ParasGore/Rocket-Team---NDTU/NDTU/Tele board.kicad_pcb

## KiCad design NDTU/Tele board.kicad_pcb (2026-11-08)

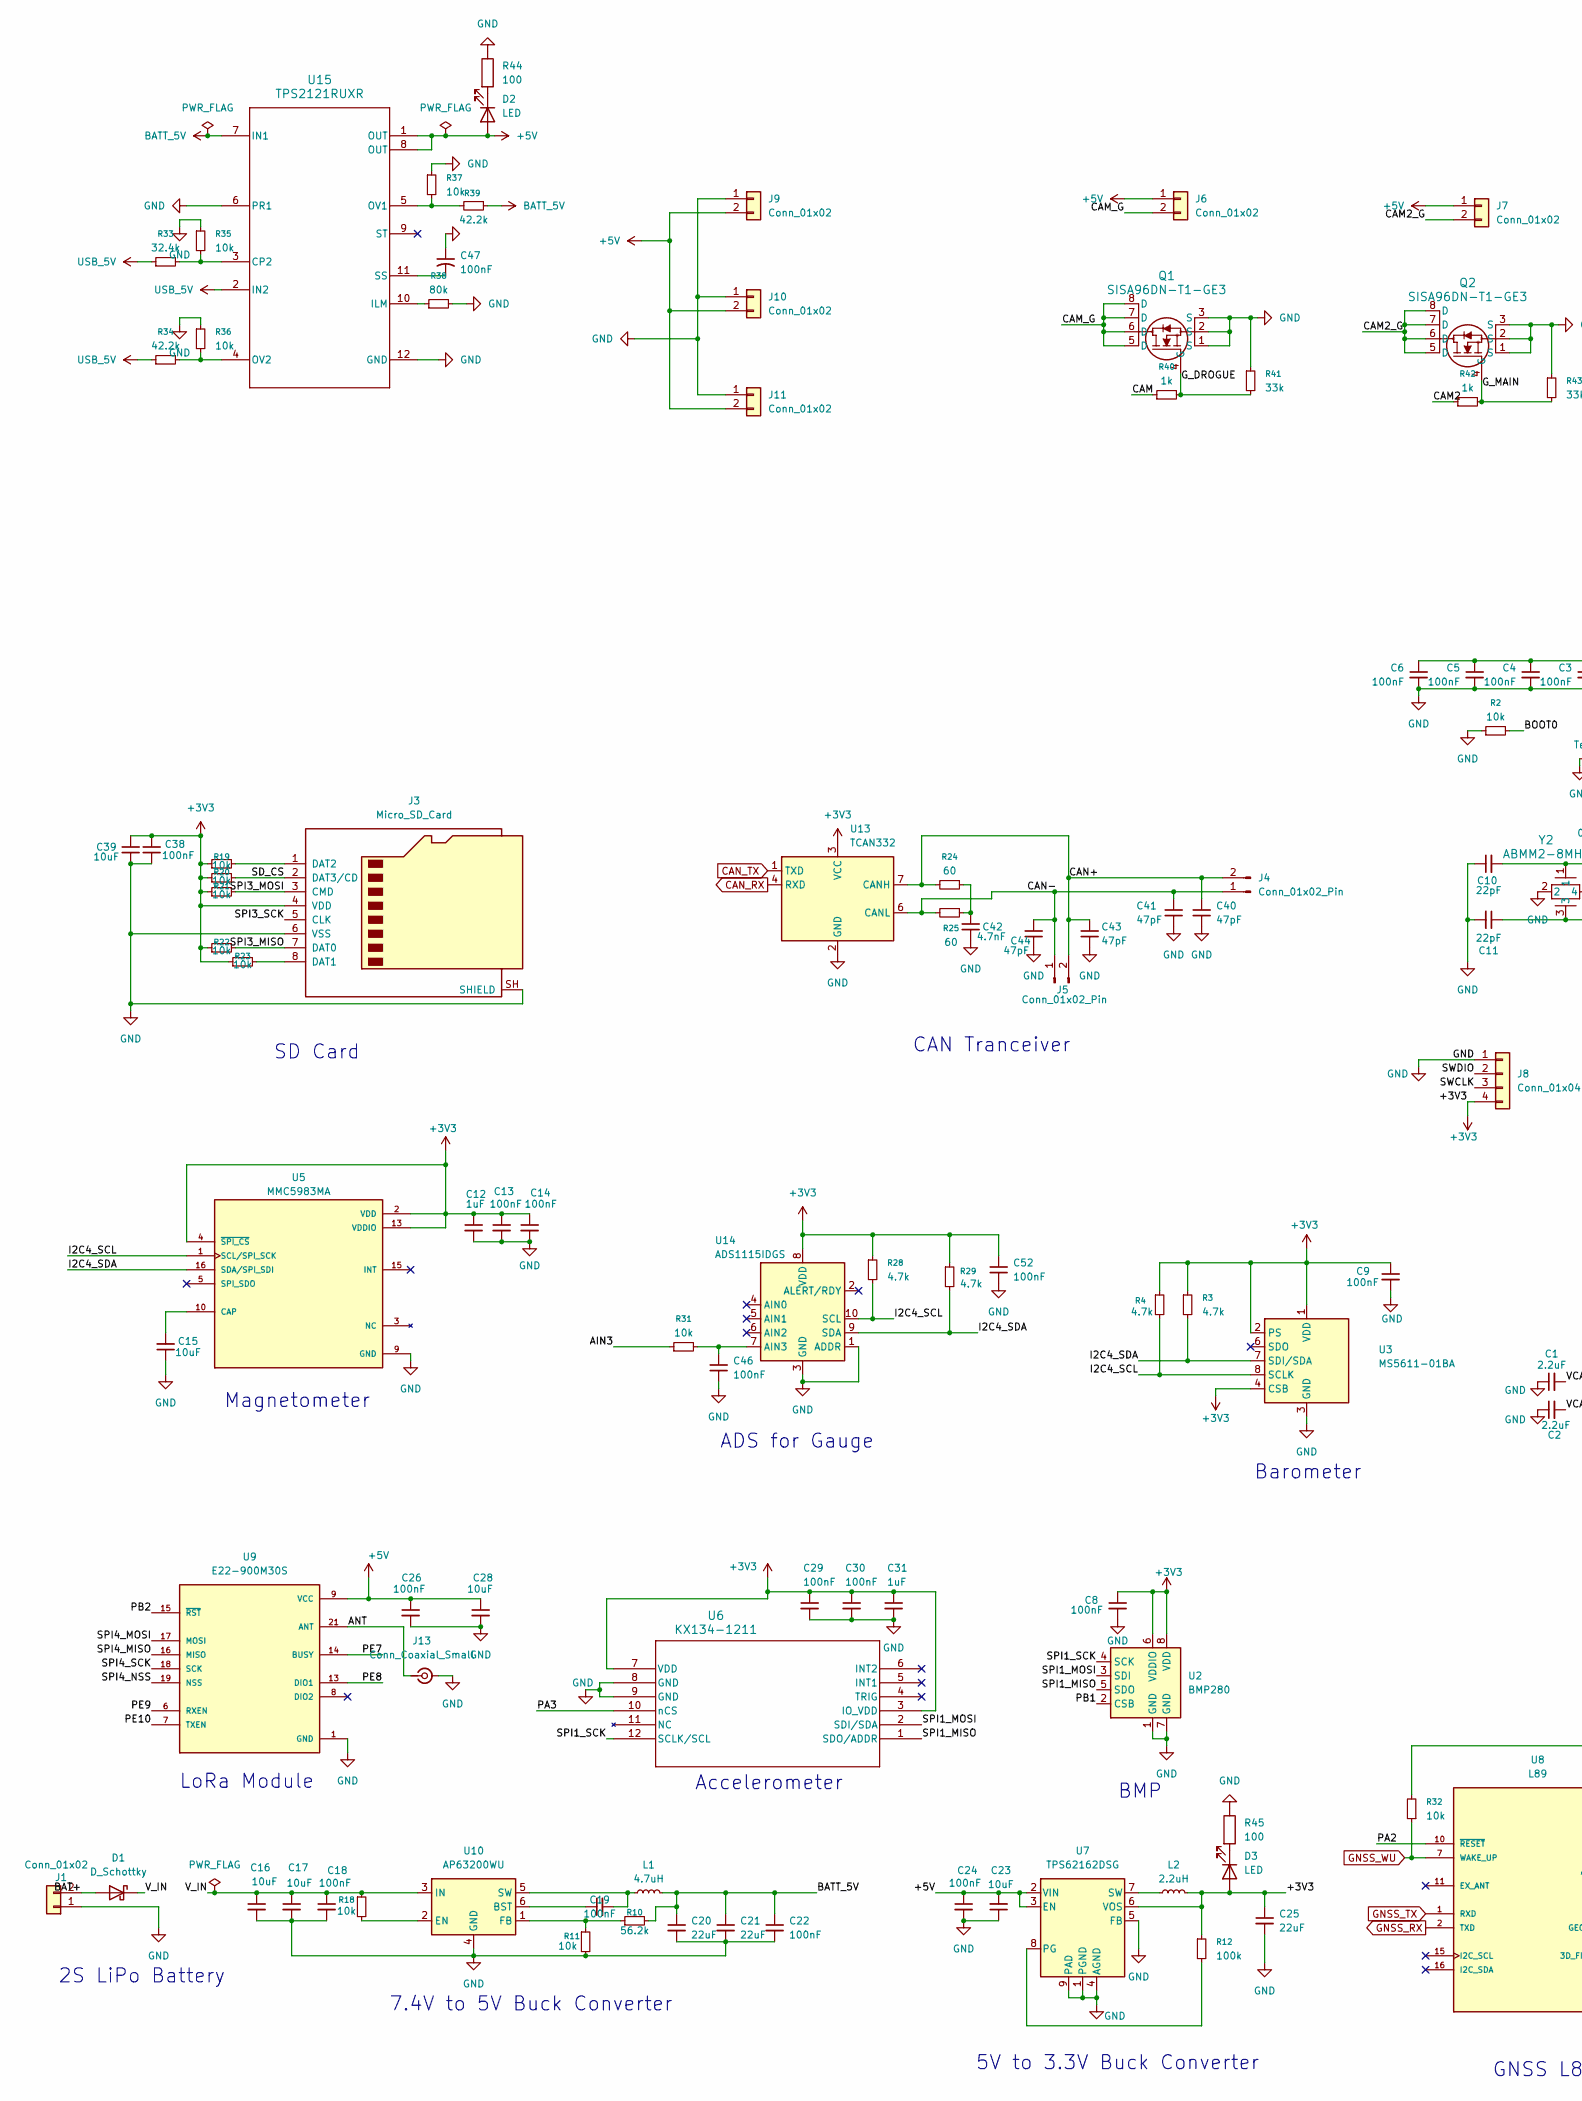
[picture p1: schematic Tele board.kicad_sch, part in row 1, column 1]

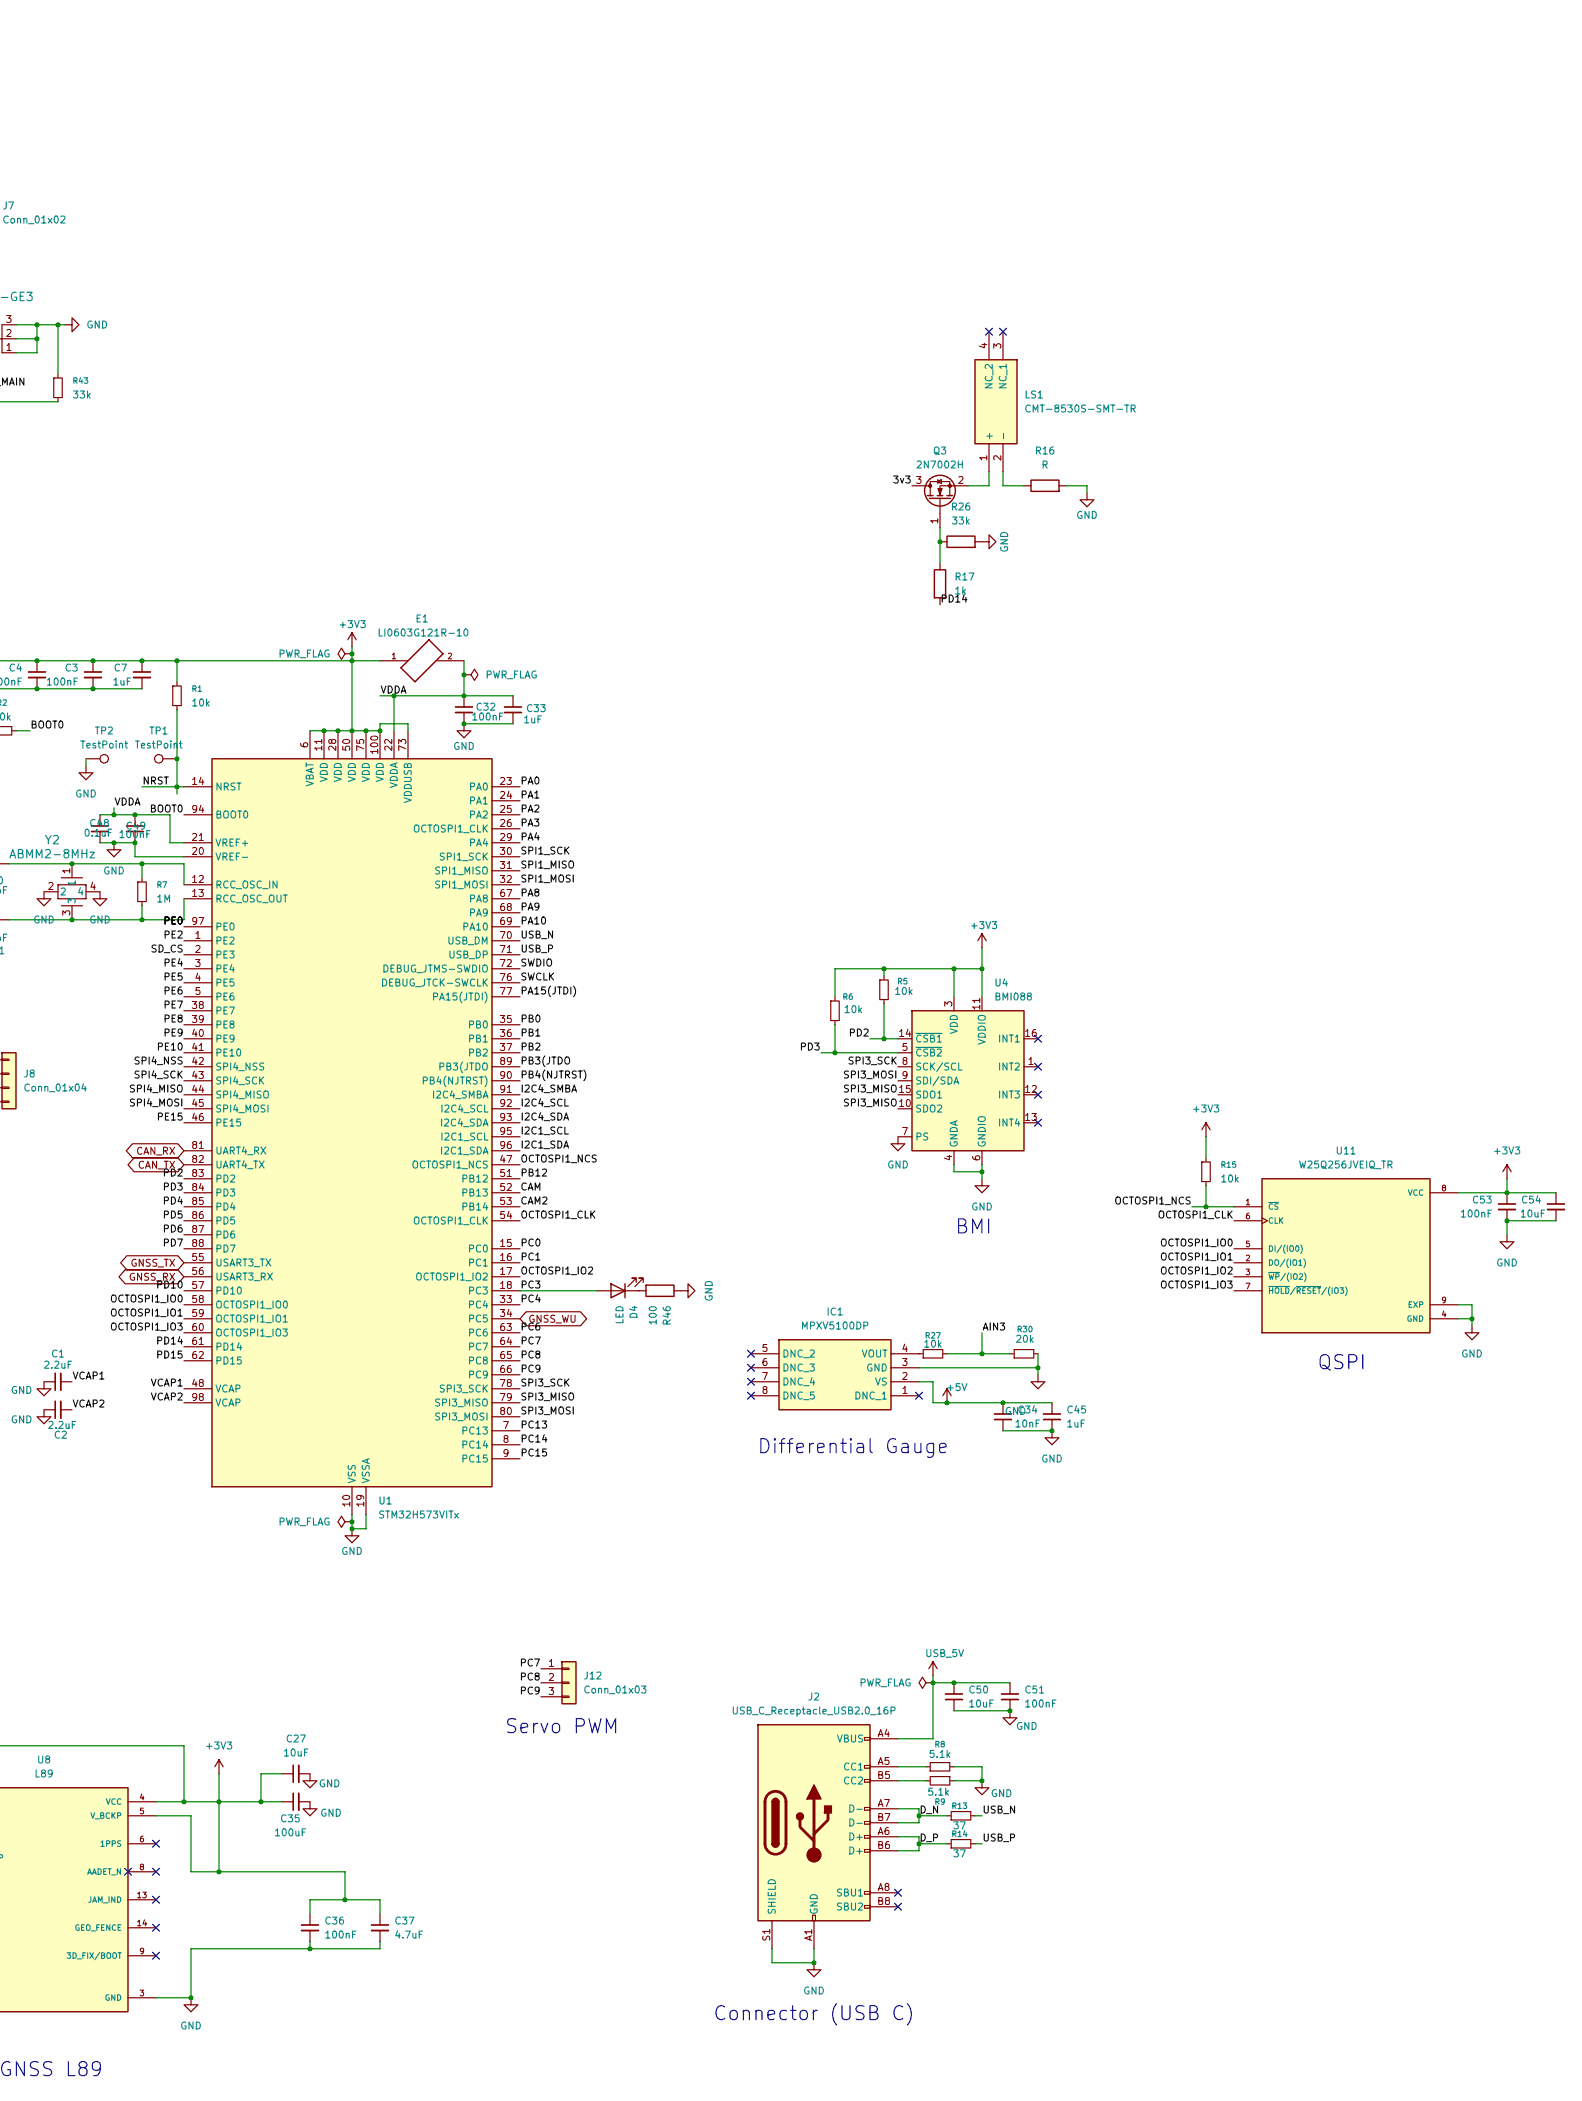
[picture p2: schematic Tele board.kicad_sch, part in row 1, column 2]

Parts:
C1, C2: 2.2uF; C_0603_1608Metric
C3, C4, C5, C6, C8, C9, C13, C14, C18, C19, C22, C24, C26, C29, C30, C32, C36, C38, C46, C47, C49, C51, C52, C53: 100nF; C_0603_1608Metric
C7, C12, C31, C33, C45: 1uF; C_0603_1608Metric
C10, C11: 22pF; C_0603_1608Metric
C15, C16, C17, C23, C27, C28, C39, C50, C54: 10uF; C_0603_1608Metric
C20, C21, C25: 22uF; C_0603_1608Metric
C34: 10nF; C_0603_1608Metric
C35: 100uF; C_0603_1608Metric
C37: 4.7uF; C_0603_1608Metric
C40, C41, C43, C44: 47pF; C_0603_1608Metric
C42: 4.7nF; C_0603_1608Metric
C48: 0.1uF; C_0603_1608Metric
D1: D_Schottky; D_SOD-128
D2, D3, D4: LED; LED_0603_1608Metric
E1: LI0603G121R-10; IND_LI0603G121R-10_LRD-M; PARTREV C
IC1: MPXV5100DP; Manufacturer_Part_Number MPXV5100DP
J1: Conn_01x02; AMASS_XT30U-M_1x02_P5.0mm_Vertical
J2: USB_C_Receptacle_USB2.0_16P; USB_C_Receptacle_GCT_USB4105-xx-A_16P_TopMnt_Horizontal
J3: Micro_SD_Card; microSD_HC_Hirose_DM3AT-SF-PEJM5
J4, J5: Conn_01x02_Pin; JST_EH_B2B-EH-A_1x02_P2.50mm_Vertical
J6, J7, J9, J10, J11: Conn_01x02; JST_EH_B2B-EH-A_1x02_P2.50mm_Vertical
J8: Conn_01x04; JST_EH_B4B-EH-A_1x04_P2.50mm_Vertical
J12: Conn_01x03; AMASS_MR30PW-M_1x03_P3.50mm_Horizontal
J13: Conn_Coaxial_Small; SMA_Samtec_SMA-J-P-H-ST-EM1_EdgeMount
L1: 4.7uH; L_Coilcraft_XAL4020-XXX
L2: 2.2uH; L_Coilcraft_XAL4020-XXX
LS1: CMT-8530S-SMT-TR; CMT8530SSMTTR; Manufacturer_Part_Number CMT-8530S-SMT-TR; Mouser Part Number 490-CMT-8530S-SMT-TR
Q1, Q2: SISA96DN-T1-GE3; SIS862DNT1GE3
Q3: 2N7002H; SOT-23
R1, R2, R5, R6, R11, R15, R18, R19, R20, R21, R22, R23, R27, R31, R32, R35, R36, R37: 10k; R_0603_1608Metric
R3, R4, R28, R29: 4.7k; R_0603_1608Metric
R7: 1M; R_0603_1608Metric
R8, R9: 5.1k; R_0603_1608Metric
R10: 56.2k; R_0603_1608Metric
R12: 100k; R_0603_1608Metric
R13, R14: 37; R_0603_1608Metric
R16: R; R_0603_1608Metric
R17, R40, R42: 1k; R_0603_1608Metric
R24, R25: 60; R_0603_1608Metric
R26, R41, R43: 33k; R_0603_1608Metric
R30: 20k; R_0603_1608Metric
R33: 32.4k; R_0603_1608Metric
R34, R39: 42.2k; R_0603_1608Metric
R38: 80k; R_0603_1608Metric
R44, R45, R46: 100; R_0603_1608Metric
TP1, TP2: TestPoint; TestPoint_Pad_2.0x2.0mm
U1: STM32H573VITx; LQFP-100_14x14mm_P0.5mm
U2: BMP280; Bosch_LGA-8_2x2.5mm_P0.65mm_ClockwisePinNumbering
U3: MS5611-01BA; LGA-8_3x5mm_P1.25mm
U4: BMI088; Bosch_LGA-16_4.5x3mm_P0.5mm_LayoutBorder7x1y_ClockwisePinNu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
U5: MMC5983MA; PQFN50P300X300X100-16N; PARTREV A
U6: KX134-1211; LGA12_2X2X0P9_ROM-M
U7: TPS62162DSG; Texas_DSG0008A_WSON-8-1EP_2x2mm_P0.5mm_EP0.9x1.6mm_ThermalV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
U8: L89; XCVR_L89; PARTREV 1.1
U9: E22-900M30S; XCVR_E22-900M30S; PARTREV 1.2
U10: AP63200WU; TSOT-23-6
U11: W25Q256JVEIQ_TR; W25Q256JVEIQ; MPN W25Q256JVEIQ TR
U13: TCAN332; SOIC-8_3.9x4.9mm_P1.27mm
U14: ADS1115IDGS; TSSOP-10_3x3mm_P0.5mm
U15: TPS2121RUXR; IC_TPS2121RUXR
Y2: ABMM2-8MHz; CRYSTAL_ABMM2_ABR

Connections:
+3V3: C3.1, C4.1, C5.1, C6.1, C7.1, C8.1, C9.1, C12.1, C13.1, C14.1, C25.1, C27.1, C29.1, C30.1, C31.1, C35.1, C36.1, C37.1, C38.1, C39.1, C52.1, C53.1, C54.1, D3.2 (A), E1.1, J3.4 (VDD), J8.4, L2.2, R1.1, R3.1, R4.1, R5.1, R6.1, R12.1, R15.1, R19.1, R20.1, R21.1, R22.1, R23.1, R28.1, R29.1, R32.2, U1.6 (VBAT), U1.11 (VDD), U1.28 (VDD), U1.50 (VDD), U1.73 (VDDUSB), U1.75 (VDD), U1.100 (VDD), U2.6 (VDDIO), U2.8 (VDD), U3.1 (VDD), U3.2 (PS), U3.4 (CSB), U3.5 (CSB), U4.3 (VDD), U4.11 (VDDIO), U5.2 (VDD), U5.4 (~SPI_CS), U5.13 (VDDIO), U6.3 (IO_VDD), U6.7 (VDD), U7.6 (VOS), U8.4 (VCC), U8.5 (V_BCKP), U11.8 (VCC), U13.3 (VCC), U14.8 (VDD)
+5V: C23.2, C24.1, C26.1, C28.1, C34.1, C45.1, D2.2 (A), IC1.2 (VS), J6.1, J7.1, J9.2, J10.2, J11.2, U7.2 (VIN), U7.3 (EN), U9.9 (VCC), U9.10 (VCC), U15.1 (OUT), U15.8 (OUT)
/3v3: Q3.3 (D)
/AIN3: R27.2, R30.1, R31.1
/ANT: J13.1 (In), U9.21 (ANT)
/BAT+: D1.2 (A), J1.2
/BOOT0: R2.2, U1.94 (BOOT0)
/CAM: R40.1, U1.52 (PB13)
/CAM2: R42.1, U1.53 (PB14)
/CAM2_G: J7.2, Q2.5 (D), Q2.6 (D), Q2.7 (D), Q2.8 (D)
/CAM_G: J6.2, Q1.5 (D), Q1.6 (D), Q1.7 (D), Q1.8 (D)
/CAN+: C40.1, C43.1, J4.2, J5.2, R24.2, U13.7 (CANH); also elsewhere on the board
/CAN-: C41.1, C44.1, J4.1, J5.1, R25.2, U13.6 (CANL); also elsewhere on the board
/D_N: J2.A7 (D-), J2.B7 (D-), R13.1
/D_P: J2.A6 (D+), J2.B6 (D+), R14.1
/G_DROGUE: Q1.4 (G), R40.2, R41.2
/G_MAIN: Q2.4 (G), R42.2, R43.2
/I2C1_SCL: U1.95 (I2C1_SCL)
/I2C1_SDA: U1.96 (I2C1_SDA)
/I2C4_SCL: R4.2, R28.2, U1.92 (I2C4_SCL), U3.8 (SCLK), U5.1 (SCL/SPI_SCK), U14.10 (SCL)
/I2C4_SDA: R3.2, R29.2, U1.93 (I2C4_SDA), U3.7 (SDI/SDA), U5.16 (SDA/SPI_SDI), U14.9 (SDA)
/I2C4_SMBA: U1.91 (I2C4_SMBA)
/NRST: R1.2, TP1.1 (1_1), U1.14 (NRST)
/OCTOSPI1_CLK: U1.54 (OCTOSPI1_CLK), U11.6 (CLK)
/OCTOSPI1_IO0: U1.58 (OCTOSPI1_IO0), U11.5 (DI/(IO0))
/OCTOSPI1_IO1: U1.59 (OCTOSPI1_IO1), U11.2 (DO/(IO1))
/OCTOSPI1_IO2: U1.17 (OCTOSPI1_IO2), U11.3 (~WP/(IO2))
/OCTOSPI1_IO3: U1.60 (OCTOSPI1_IO3), U11.7 (~HOLD/~RESET/(IO3))
/OCTOSPI1_NCS: R15.2, U1.47 (OCTOSPI1_NCS), U11.1 (~CS)
/PA0: U1.23 (PA0)
/PA1: U1.24 (PA1)
/PA2: U1.25 (PA2), U8.10 (~RESET)
/PA3: U1.26 (OCTOSPI1_CLK), U6.10 (nCS)
/PA4: U1.29 (PA4)
/PA8: U1.67 (PA8)
/PA9: U1.68 (PA9)
/PA10: U1.69 (PA10)
/PA15(JTDI): U1.77 (PA15(JTDI))
/PB0: U1.35 (PB0)
/PB1: U1.36 (PB1), U2.2 (CSB)
/PB2: U1.37 (PB2), U9.15 (~RST)
/PB3(JTDO: U1.89 (PB3(JTDO)
/PB4(NJTRST): U1.90 (PB4(NJTRST))
/PB12: U1.51 (PB12)
/PC0: U1.15 (PC0)
/PC1: U1.16 (PC1)
/PC3: D4.2 (A), U1.18 (PC3)
/PC4: U1.33 (PC4)
/PC6: U1.63 (PC6)
/PC7: J12.1, U1.64 (PC7)
/PC8: J12.2, U1.65 (PC8)
/PC9: J12.3, U1.66 (PC9)
/PC13: U1.7 (PC13)
/PC14: U1.8 (PC14)
/PC15: U1.9 (PC15)
/PD2: R5.2, U1.83 (PD2), U4.14 (~CSB1)
/PD3: R6.2, U1.84 (PD3), U4.5 (~CSB2)
/PD4: U1.85 (PD4)
/PD5: U1.86 (PD5)
/PD6: U1.87 (PD6)
/PD7: U1.88 (PD7)
/PD10: U1.57 (PD10)
/PD14: R17.2, U1.61 (PD14)
/PD15: U1.62 (PD15)
/PE0: U1.97 (PE0)
/PE2: U1.1 (PE2)
/PE4: U1.3 (PE4)
/PE5: U1.4 (PE5)
/PE6: U1.5 (PE6)
/PE7: U1.38 (PE7), U9.14 (BUSY)
/PE8: U1.39 (PE8), U9.13 (DIO1)
/PE9: U1.40 (PE9), U9.6 (RXEN)
/PE10: U1.41 (PE10), U9.7 (TXEN)
/PE15: U1.46 (PE15)
/SD_CS: J3.2 (DAT3/CD), R20.2, U1.2 (PE3)
/SPI1_MISO: U1.31 (SPI1_MISO), U2.5 (SDO), U6.1 (SDO/ADDR)
/SPI1_MOSI: U1.32 (SPI1_MOSI), U2.3 (SDI), U6.2 (SDI/SDA)
/SPI1_SCK: U1.30 (SPI1_SCK), U2.4 (SCK), U6.12 (SCLK/SCL)
/SPI3_MISO: J3.7 (DAT0), R22.2, U1.79 (SPI3_MISO), U4.10 (SDO2), U4.15 (SDO1)
/SPI3_MOSI: J3.3 (CMD), R21.2, U1.80 (SPI3_MOSI), U4.9 (SDI/SDA)
/SPI3_SCK: J3.5 (CLK), U1.78 (SPI3_SCK), U4.8 (SCK/SCL)
/SPI4_MISO: U1.44 (SPI4_MISO), U9.16 (MISO)
/SPI4_MOSI: U1.45 (SPI4_MOSI), U9.17 (MOSI)
/SPI4_NSS: U1.42 (SPI4_NSS), U9.19 (NSS)
/SPI4_SCK: U1.43 (SPI4_SCK), U9.18 (SCK)
/SWCLK: J8.3, U1.76 (DEBUG_JTCK-SWCLK)
/SWDIO: J8.2, U1.72 (DEBUG_JTMS-SWDIO)
/USB_N: R13.2, U1.70 (USB_DM)
/USB_P: R14.2, U1.71 (USB_DP)
/VCAP1: C1.2, U1.48 (VCAP)
/VCAP2: C2.2, U1.98 (VCAP)
/VDDA: C32.1, C33.1, C48.1, C49.1, E1.2, U1.21 (VREF+), U1.22 (VDDA)
/V_IN: C16.1, C17.1, C18.1, D1.1 (K), R18.1, U10.3 (IN)
BATT_5V: C20.1, C21.1, C22.1, L1.2, R10.2, R39.1, U15.7 (IN1)
CAN_RX: U1.81 (UART4_RX), U13.4 (RXD)
CAN_TX: U1.82 (UART4_TX), U13.1 (TXD)
GND: C1.1, C2.1, C3.2, C4.2, C5.2, C6.2, C7.2, C8.2, C9.2, C10.1, C11.2, C12.2, C13.2, C14.2, C15.1, C16.2, C17.2, C18.2, C20.2, C21.2, C22.2, C23.1, C24.2, C25.2, C26.2, C27.2, C28.2, C29.2, C30.2, C31.2, C32.2, C33.2, C34.2, C35.2, C36.2, C37.2, C38.2, C39.2, C40.2, C41.2, C42.2, C43.2, C44.2, C45.2, C46.2, C47.1, C48.2, C49.2, C50.2, C51.2, C52.2, C53.2, C54.2, IC1.3 (GND), J1.1, J2.A1 (GND), J2.A12 (GND), J2.B1 (GND), J2.B12 (GND), J2.S1 (SHIELD), J3.6 (VSS), J3.SH (SHIELD), J8.1, J9.1, J10.1, J11.1, J13.2 (Ext), Q1.1 (S), Q1.2 (S), Q1.3 (S), Q2.1 (S), Q2.2 (S), Q2.3 (S), R2.1, R8.2, R9.1, R11.2, R16.2, R26.2, R30.2, R35.1, R36.1, R37.1, R38.2, R41.1, R43.1, R44.1, R45.1, R46.1, TP2.1 (1_1), U1.10 (VSS), U1.19 (VSSA), U1.20 (VREF-), U1.27 (VSS), U1.49 (VSS), U1.74 (VSS), U1.99 (VSS), U2.1 (GND), U2.7 (GND), U3.3 (GND), U4.2 (GNDA), U4.4 (GNDA), U4.6 (GNDIO), U4.7 (PS), U5.9 (GND), U5.11 (GND), U6.8 (GND), U6.9 (GND), U7.1 (PGND), U7.4 (AGND), U7.5 (FB), U7.9 (PAD), U8.3 (GND), U8.12 (GND), U9.1 (GND), U9.2 (GND), U9.3 (GND), U9.4 (GND), U9.5 (GND), U9.11 (GND), U9.12 (GND), U9.20 (GND), U9.22 (GND), U10.4 (GND), U11.4 (GND), U11.9 (EXP), U13.2 (GND), U14.1 (ADDR), U14.3 (GND), U15.6 (PR1), U15.12 (GND), Y2.2, Y2.4; also elsewhere on the board
GNSS_RX: U1.56 (USART3_RX), U8.2 (TXD)
GNSS_TX: U1.55 (USART3_TX), U8.1 (RXD)
GNSS_WU: R32.1, U1.34 (PC5), U8.7 (WAKE_UP)
unnamed: C42.1, R24.1, R25.1
unnamed: D2.1 (K), R44.2
unnamed: D3.1 (K), R45.2
unnamed: D4.1 (K), R46.2
unnamed: IC1.4 (VOUT), R27.1
unnamed: J2.A5 (CC1), R8.1
unnamed: J2.B5 (CC2), R9.2
unnamed: J3.8 (DAT1), R23.2
unnamed: J3.1 (DAT2), R19.2
unnamed: LS1.1 (+), Q3.2 (S)
unnamed: LS1.2 (-), R16.1
unnamed: Q3.1 (G), R17.1, R26.1
unnamed: C10.2, R7.1, U1.12 (RCC_OSC_IN), Y2.1
unnamed: C11.1, R7.2, U1.13 (RCC_OSC_OUT), Y2.3
unnamed: C15.2, U5.10 (CAP)
unnamed: R12.2, U7.8 (PG)
unnamed: L2.1, U7.7 (SW)
unnamed: C19.1, U10.6 (BST)
unnamed: R18.2, U10.2 (EN)
unnamed: R10.1, R11.1, U10.1 (FB)
unnamed: C19.2, L1.1, U10.5 (SW)
unnamed: C46.1, R31.2, U14.7 (AIN3)
unnamed: R33.2, R35.2, U15.3 (CP2)
unnamed: R38.1, U15.10 (ILM)
unnamed: R37.2, R39.2, U15.5 (OV1)
unnamed: R34.2, R36.2, U15.4 (OV2)
unnamed: C47.2, U15.11 (SS)
USB_5V: C50.1, C51.1, J2.A4 (VBUS), J2.A9 (VBUS), J2.B4 (VBUS), J2.B9 (VBUS), R33.1, R34.1, U15.2 (IN2)

Notes on the sheet:
ADS for Gauge
GNSS L89
5V to 3.3V Buck Converter
QSPI
Connector (USB C)
Barometer
Magnetometer
BMI
BMP
2S LiPo Battery
SD Card
Differential Gauge
CAN Tranceiver
Servo PWM
Accelerometer
LoRa Module
7.4V to 5V Buck Converter

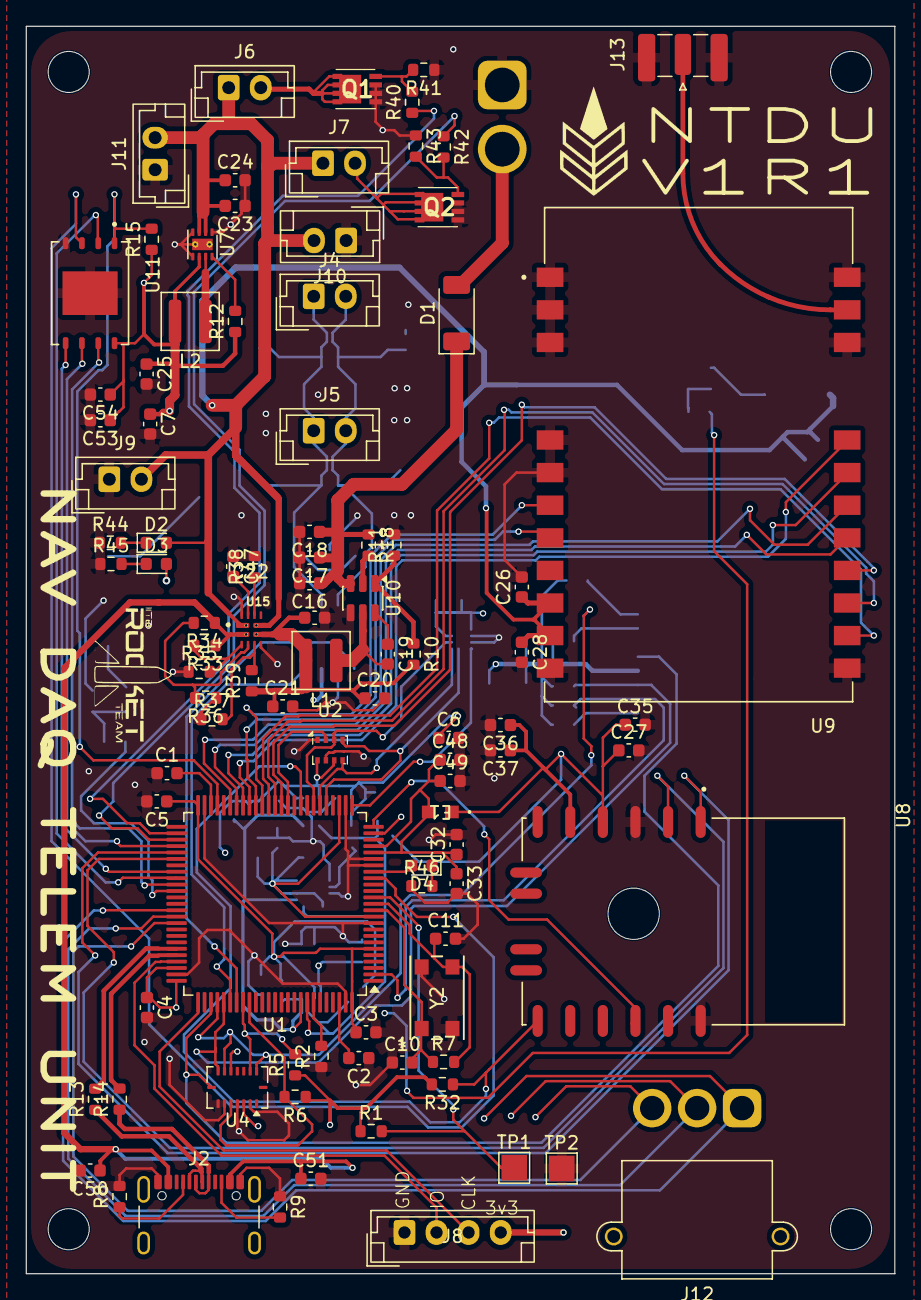
[picture p3: board Tele board.kicad_pcb from above]

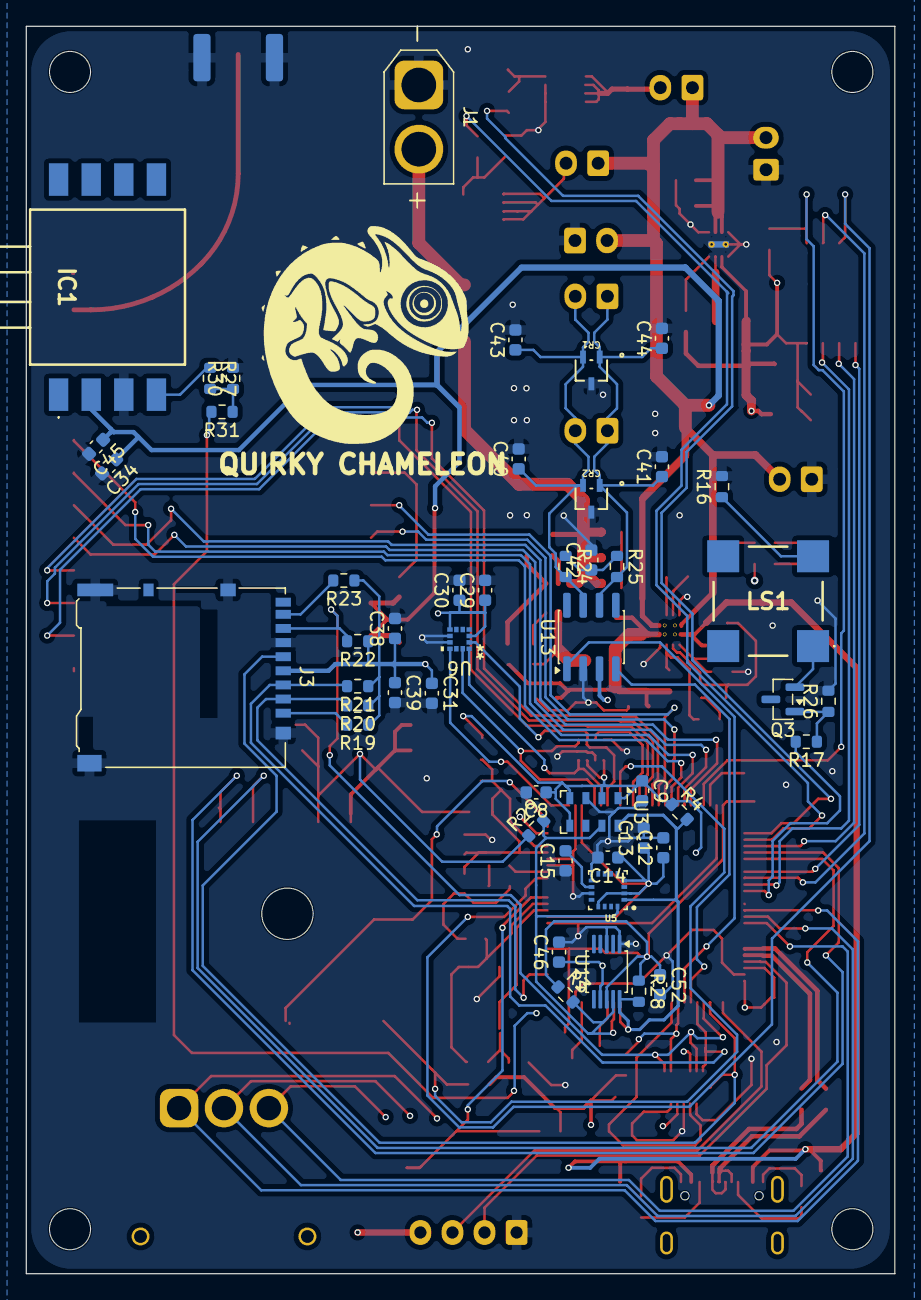
[picture p4: board Tele board.kicad_pcb from below]

Board: 4 copper layers, 67.7 x 97.2 mm, 144 parts (49 on the bottom side), 94 nets.

Other parts of the board:
CR1, CR2: ESDCAN02-2BWY; SOT323-3L_STM

Their connections:
/CAN+: CR1.2, CR2.2; also elsewhere on the board
/CAN-: CR1.1, CR2.1; also elsewhere on the board
GND: CR1.3, CR2.3; also elsewhere on the board
