ParasGore/Rocket-Team---NDTU/(commit log)

2026-11-07 GND plane, USB, Antenna sorted
2026-11-08 Cooked up the buzzer and led
